ElektronikaDonBosco/Mesa-de-mezclas/README.md

# MESA DE MEZCLAS

## GRUPO_MIXER_1500 (Irene, Aritz y Amaia)

### Este proyecto consiste en una mesa de mezclas. La mesa de mezcla de audio o mezcladora de sonidos es un dispositivo electrónico al cual se conectan diversos elementos emisores de audio, tales como micrófonos etc. 

### Antes de profundizar en nuestro proyecto aquí tenéis la introducción de lo que vamos a ver:
Mesa

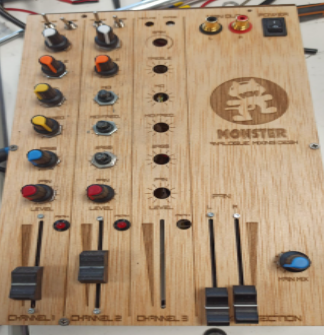
[picture p1: Imágenes/mesa_chasis.PNG]


# Introdución

## 1.- Presentación General

## 2.- Cómo funciona una mesa de mezclas (con sus partes)

### a- Entrada de audio

### b- Preamplificación

### c- Control de tono

### d- Fader y módulo de panorama

### e- Indicador de sobrecarga overload indicator

### f-Master
### g-Salida circuito
## 3.-Fuente de alimentación 
## 4.-Prototipo y diseño del chasis

### a-Planos y medidas
### b-Materiales

## 5.- Componentes importantes/distintos
### a-Potenciómetros
### b-Conmutadores

## 6.- Programas que hemos utilizado

### a-Proteus
### b-Circuit Cam

## 7.- Como hicimos el proyecto

## 8.- Futuras mejoras

## 9- Conclusiones
### -

### -

### -

## 1.- Presentación General

### Este proyecto ha sido desarrollado por alumnos de Mantenimiento Electrónico de Don Bosco (Errenteria). El proyecto tuvo inicio a mediados de Diciembre del 2020 y finalizo a mediados de Febrero del 2021.

### Esta mesa está alimentada a +15V y -15V  y tendrá un overload por si hay alguna sobrecarga además de un master. La mesa se compone de 3 canales de audio con entradas Jac y XLR cada una y salidas RCA en el Master.

### En cuanto a su chasis se hizo de parte de madera y parte metacrilato.

## 2.- Cómo funciona una mesa de mezclas (con sus partes)

### a.- MICRÓFONO Y PREAMPLIFICACIÓN

### Conexionado entradas:
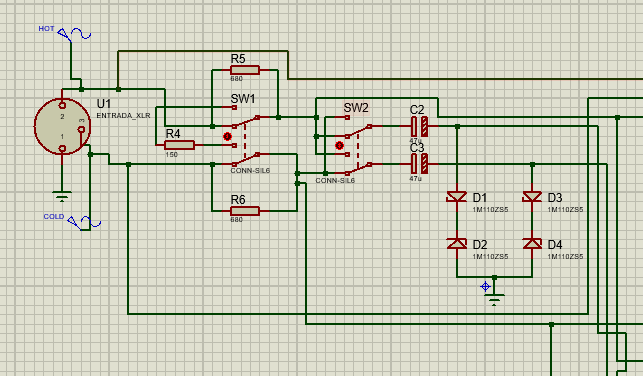
[picture p2: Imágenes/ENTRADA_AUDIO.PNG]
ENTRADA_AUDIO

### Para el micrófono se ha puesto un conector XLR o Jac ya que son para insertar cables con señal balanceada, es decir, el bus tiene tres conectores. 
#### En un conductor se manda la señal de audio (positivo o Hot) y en el otro se manda la misma señal, pero de forma invertida es decir, con un desfase de 180º (negativo o Cold), el tercer conductor sería la tierra de nuestra entrada de audio. 
#### Nuestro conector:



##### En está imagen podéis ver el conexionado de los extremos del cable XLR



###### 1-GROUND
###### 2-V+
###### 3-V-

##### En está imagen podéis ver el conexionado de los extremos del cable XLR

##### En está imagen podéis ver el conexionado del cable Jac comparado y con los XLR



#### Con este tipo de conexión logramos eliminar el ruido y obtener un audio de mayor volumen y amplitud, que se logra de la siguiente manera: al momento de conectar el cable a un preamplificador, el equipo invierte la señal que viene en el conductor &quot;Cold&quot; convirtiéndola en una señal igual a la señal &quot;Hot&quot;, con la característica de que el ruido que lleva se queda en la misma forma.

#### El equipo suma la señal del conductor &quot;Hot&quot; con la señal &quot;Cold&quot;, el resultado es una señal de audio del doble de amplitud y una cancelación de ruido, ya que están en sentido contrario. Con la siguiente imagen vemos de forma gráfica lo que sucede:
Hot y COLD



### En la preamplificación tenemos dos switches:

### Primer switch: 
#### Se encarga de conmutar la señal. Si se quiere conectar un instrumento de línea, se activa el switch para el otro lado, la señal hot pasa por R5 y la señal cold pasa por R6, y además, se quedan Cold y hot conectados entre ellos. En esa configuración se consigue un desgaste de 20dB. O dicho de otra forma, a la hora de conectar un instrumento con una tensión mayor se activa una resistencia adicional para que nuestro circuito pueda soportarla.
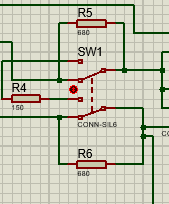
[picture p3: Imágenes/sw1.PNG]
sw1


### Segundo switch: 
#### Se encarga de hacer la suma de las señales la de entrada hot y la entrada cold (con un desfase de 180º). Si hay dos micrófonos si uno está muy cerca del otro, es posible que se solapen esto hace que las señales se anulen entre sí. Para que esto no pase la señal de un micrófono se desfasa 180º.

sw2


### b.-Preamplificación
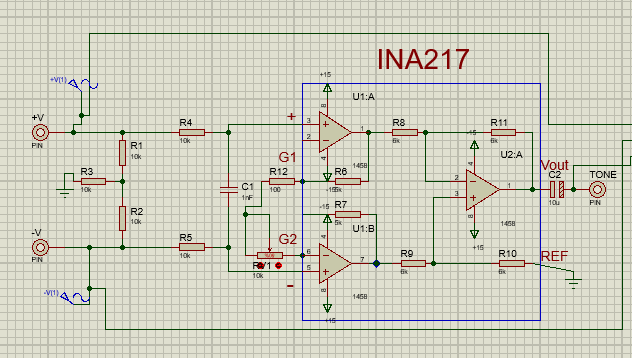
[picture p4: Imágenes/PREAMPLIFICACIÓN.PNG]
preamp
 

### En está etapa como podéis ver contaremos con el INA217 o tambien llamado amplificador instrumental, el cual, se compone interiormente por 3 amplificadores, su función principal es unir las dos señales La hot y cold para así solo optener una a la salida amplificada de está etapa.

#### El INA217 es ideal para señales de audio de bajo nivel, como baja impedancia balanceada micrófonos, muchos instrumentos industriales, médicos y de instrumentación. Las aplicaciones también se benefician de su bajo nivel de ruido y amplio ancho de banda. Los circuitos de cancelación de distorsión únicos reducen la distorsión a niveles extremadamente bajos, incluso en alta ganancia. 
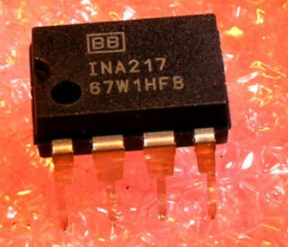
[picture p5: Imágenes/INA_FOTO.PNG]




### -Circuito de amplificación: Se basa en un amplificador no invertido.
#### La resistencia variable RV1 tiene una masa conectada. Cuando el cursor está en el medio de RV1, 50% de la trayectoria de RV1, las ondas de salida y entrada son las mismas, con ganancia = 1 o 0 dB.

#### Cuando el cursor se coloca en el 75% de la trayectoria RV1, la masa se acerca a la entrada positiva y la señal se cancela. Si los valores R1, RV1 y R2 tienen los valores correctos, como se muestra en la figura, colocando el cursor en esta posición, la señal de salida será la mitad de la entrada, la ganancia es = 0.5 o -6db.
#### Cuando coloca el cursor en el 25% de la trayectoria RV1, la masa se acerca a la entrada negativa. Cuando la señal se cancela en la entrada negativa, se amplificará en la salida. Ganancia = 2db-6db. 

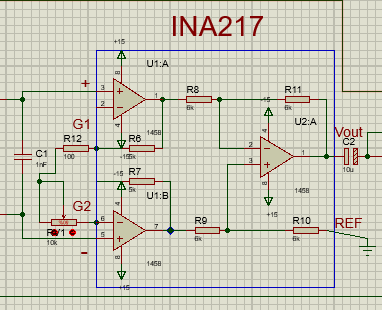
[picture p6: Imágenes/INA217.PNG]
ina


### En está etapa también es importante añadir que contamos con un potenciómetro. Pero no es un potenciómetro cualquiera sino uno logarítmico. Este tipo de potenciómetros los explicaremos con más detalle en componentes importes de nuestro circuito. Este potenciómetro tendrá que ser de 10 Ks.



### C-Módulo de tono
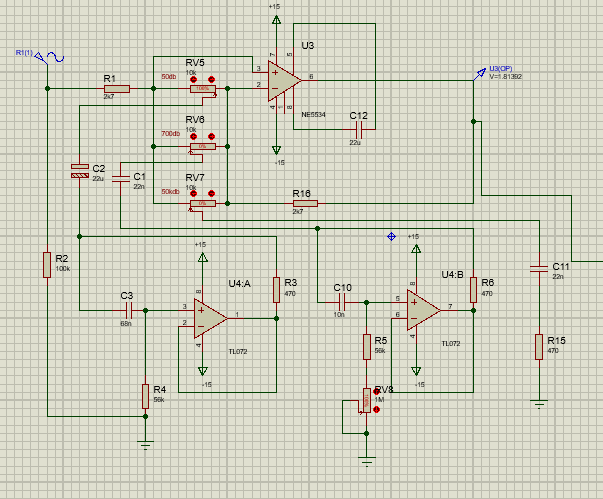
[picture p7: Imágenes/MÓDULO_TONO.PNG]
cc
 
### Para esté circuito necesitaremos 2 amplificadores operacionales un NE5534 y un TL072
#### NE5534:





#### TL072:





### En está etapa todos los potenciómetros serán lineales.
#### En esta etapa según la señal que recibamos bien sea de altos(Rv7), medios(Rv6) o bajos(Rv5)  podremos balancear la señal a la mejor calidad auditiva según a cuanta frecuencia esté llegando nuestra señal. Estos potenciómetros serán de 10Ks.



s

#### De la misma manera en este circuito contamos con un potenciómetro adicional de 1M:



#### Con este potenciómetro podremos balancear la señal en caso de que esté en el punto medio:
#### -bajo-medio
#### -medio-alto 

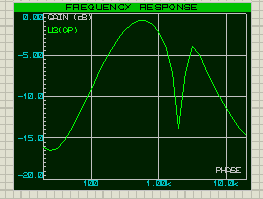
[picture p8: Imágenes/GRÁFICO_TONO.PNG]


#### En cuanto a las frecuencia que se adecua a cada etapa aquí tenéis un resumido esquema de estas frecuencias:
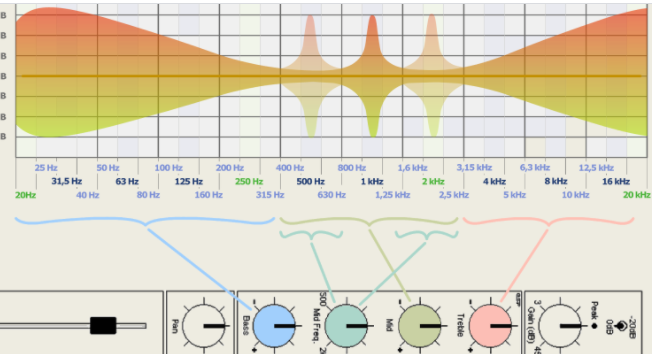
[picture p9: Imágenes/tono_hz.PNG]

#### -Azul: Bajos
#### -Verde musgo: Medios
#### -Rojo: Altos
#### -Verde pino: Potenciómetro balance (Bajo-Medio) y (Medio-Alto)

### d.-Fader y módulo de panorama

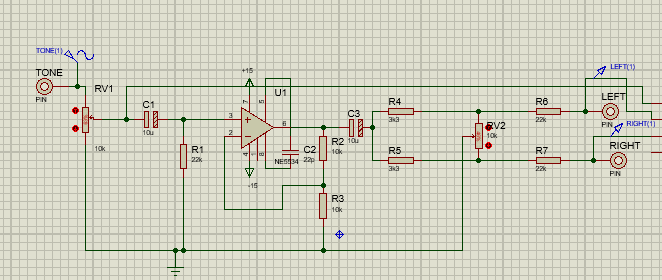
[picture p10: Imágenes/FADER.PNG]


### Para está etapa utilizaremos el amplificador NE5534 de nuevo y un fadder(logarítmico) y un potenciómetro lineal los dos de 10Ks.
### Fadder:



#### El volumen de la señal se controla con el fader VR1 el cual es un potenciómetro logarítmico . Su cursor está conectado a la entrada positiva del amplificador operacional. El potenciómetro debe ser logarítmico, y el lado con mayor resistencia en el potenciómetro debe estar en la parte superior para igualar las variaciones de resistencia con las mayores diferencias de presión en volúmenes altos. Su función principal es controlar el volumen del canal.
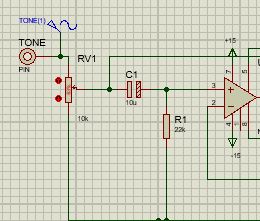
[picture p11: Imágenes/VOLUMEN.PNG]
 

#### Con el potenciómetro panorámico VR2 se puede enviar la señal a los canales izquierdo y derecho, en la proporcionalidad deseada. En resumen, Rv1 tiene la función de subir o bajar el volumen de nuestra señal y Rv2 tiene la función de dar prioridad al canal izquierdo o canal derecho de audio.
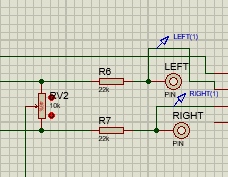
[picture p12: Imágenes/L_R.PNG]

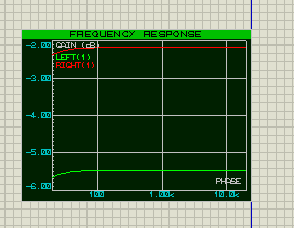
[picture p13: Imágenes/L_R_GRAFICO.PNG]


### e.-Indicador de sobrecargas "Overload Indicator")
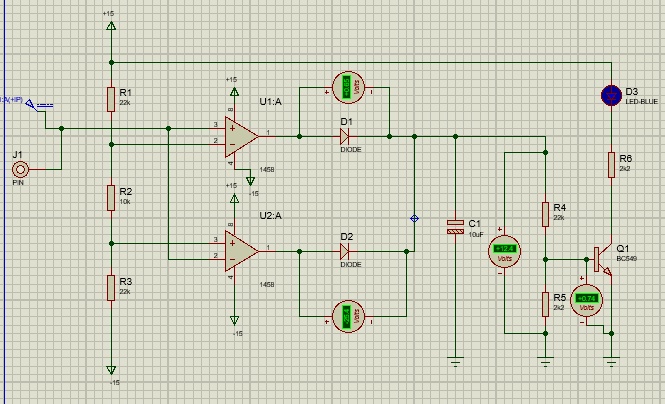
[picture p14: Imágenes/OVERLOAD.PNG]

#### Está etapa en la mesa de mezclas es opcional, su función principal es avisarnos cuando hay una sobrecarga en mi canal, este aviso no lo notificará a través de un led. Este led se encenderá cuando la tensión sea mayor a 3V o cuando esté por encima de los 6 Db. Esto sucederá cuando el transistor del esquema se excite. 
#### Esté circuito se compone principalmente de dos amplificadores LM1458 y del transistor BC549.
##### LM1458:



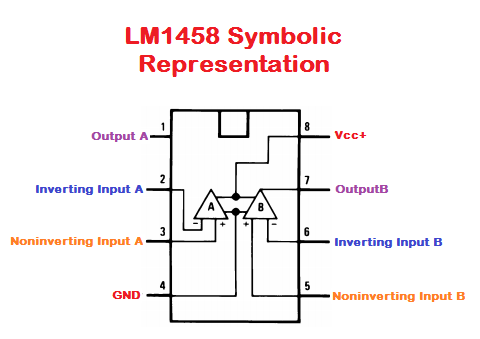
[picture p15: Imágenes/LM1458.PNG]


##### BC549: 
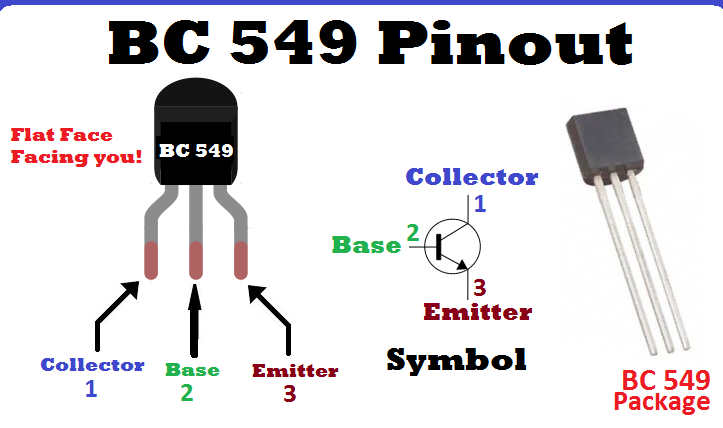
[picture p16: Imágenes/BC549.PNG]


### f.-Master:
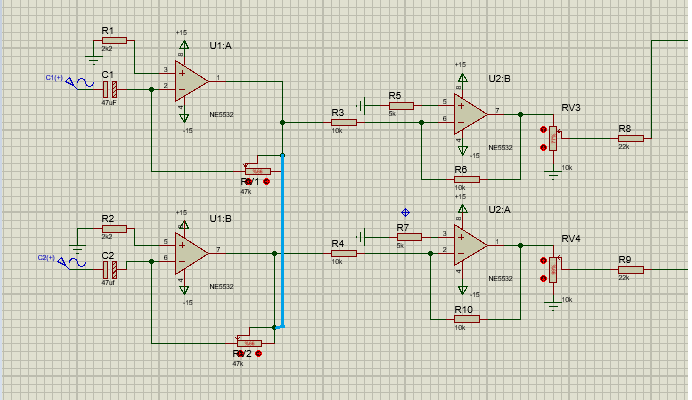
[picture p17: Imágenes/Master.PNG]

### Para está etapa necesitaremos 2 amplificadores NE5532, un potenciómetro tandem o doble(a poder ser logarítmico) de 47K y dos faders a su salida de 10ks.
##### NE5532:





##### Potenciómetro tandem: 



#### Este circuito es esencial para que esto lo podamos llamar mesa de mezclas, es la ultima etapa, al unir todas las salidas de los canales, por una parte el oído derecho Right(R) y por otra parte el oido izquierdo Left(L). 
#### Además de unir todos los canales manipula la ganancia de las entradas L y R en el circuito a través de un potenciómetro tándem.
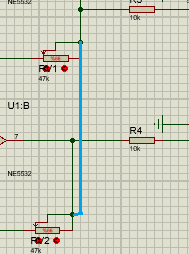
[picture p18: Imágenes/TAMDEM_ESQUEMA.PNG]

#### Al final de este circuito también disponemos con dos fadders los cuales, le van ha dar o quitar prioridad auditiva a cada entrada L o R independientemente.

### g.-Salida Circuito:
### La salida de nuestro circuito será mediante conectores RCA. El conexionado se haría de esta forma:
##### RCA:





#### -Rojo:Señal
#### -Negro:GND
## 3-Fuente de alimentación:
### Nosotros hemos calculado que nuestro circuito tiene un consumo de menos de 1A y que su alimentación es de +15v y -15V.
### Con estos datos hemos comprado una fuente de alimentación a su medida
### Fuente:
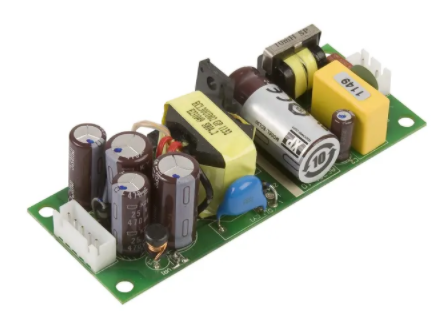
[picture p19: Imágenes/fuente.PNG]


### Link de compra:
[https://es.rs-online.com/web/p/fuentes-de-alimentacion-de-modo-conmutado-smps-integradas/1227791/](https://es.rs-online.com/web/p/fuentes-de-alimentacion-de-modo-conmutado-smps-integradas/1227791/)
## 4- Prototipo y diseño del chasis


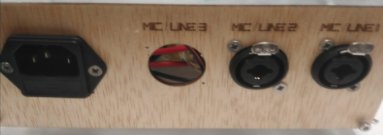
[picture p20: Imágenes/mesa_chasis2.PNG]

Esá es la página dónde nos han echo el diseño.
https://www.creartech.es/ 
### Nuestra caja está echa parte de madera y parte de metacrilato.

### La parte  trasera, los 3 laterales son de metraquilato

#### -La partes restantes es decir, el lateral superior y la parte delantera son de madera.
#### -El lateral superior tiene los conectores  de alimentación y el interruptor
#### En la parte superior tenemos: Switches, potenciómetros, Fadder , Entradas Jack/XLR y salidas RCA

#### Estás serían las medidas de nuestra caja:

## 5- Componentes importantes/distintos

### a.- Potenciómetros logarítmicos/lineales:

### -Lineales(B): En estos potenciómetros la resistencia es igual hacia ambas direcciones, hay que tomar en cuenta que el decremento de el valor de la resistencia se produzca de izquierda a derecha y no al revés.

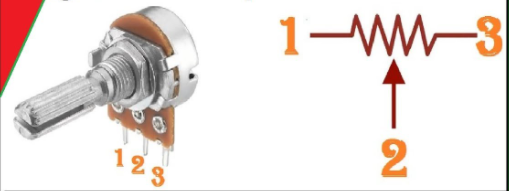
[picture p21: Imágenes/pot.PNG]


### -Logarítmicos(A):  Estos potenciómetros se caracterizan por ser exclusivos para el audio puesto que se comportan de la misma forma que un oído humano. En tensiones bajas la resistencia sería alta y en tensiones altas la resistencia sería baja. Puesto que el oído humano diferencia mejor el volumen alto al bajo. Por lo tanto la resistencia no es igual a ambos lados y esto es una cosa que hay que tener en cuenta a la hora de hacer el conexionado de los potenciómetros a la placa.



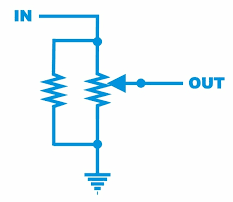
[picture p22: Imágenes/pot_log.PNG]


### b.- Fadder: Estos potenciómetros también son logarítmicos pero su patillaje es distinto. A la hora del conexionado es otro apartado a tomar en cuenta.

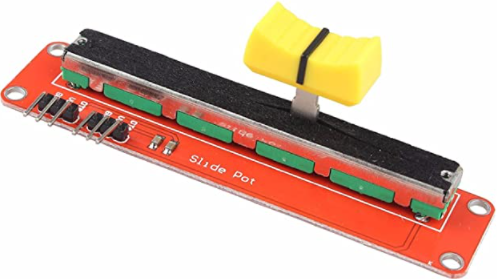
[picture p23: Imágenes/fadeee.PNG]




### c.- Switches: Los Switches del esquema y los físicos tienen un orden de patillaje lógico pero no es el mismo por lo tanto es otro apartado a tomar en cuenta. 
#### Su funcionamiento sería el siguiente, un Swich se compone de 6 pines. Cuando tu activas el interruptor los dos pines paralelos del lado opuesto se activan y salen cada uno
#### por el pin contiguo del medio. Al cambiar de dirección el interruptor pararían los pines paralelos del otro lado opuesto por los pin contiguo del medio.





##### COMPONENTES MÁS IMPORTANTES
COMPONENTES | Cantidad |
------------ | ------------ 
POTENCIMÉTROS LINEALES 10K | 12 unid
POTENCIMÉTROS LINEALES 1M| 3 unid
POTENCIMÉTROS LOG 10k | 3 unid
POTENCIMÉTRO Tamdem/lin 47K | 1 unid
FADERS    10k         | 5 unid
SWITCHES              | 6 unid
AMPLIFICADOR INA217  | 3 unid  
AMPLIFICADOR NE5534 | 6 unid
AMPLIFICADOR TL072 | 3 unid
AMPLIFICADOR LM1458 | 3 unid
AMPLIFICADOR NE5532 | 1 unid 
TRANSISTOR   BC549 |  3 unid
Entradas XLR/Jack            | 3unid
Salidas RCA     | 2 unid

## 6- Programas que hemos utilizado

### Proteus: con este programa podremos crear los diferentes circuitos que necesitamos y podremos simularlos en el. De esta forma podremos comprobar de antemano posibles fallos que pueden aparecer.

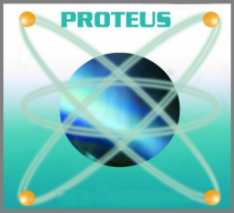
[picture p24: Imágenes/proteus.PNG]



####  Además, hay un apartado en el proteus donde podemos hacer una de una PCB y descargar todas las capas que compone el  archivo.



### CircuitCam: Cuando hallamos descargado estas capas anteriormente mencionadas podremos unificarlas en esté programa y hacer alguna pequeña modificación como un recorte al rededor de la placa o poner alguna nomenclatura en la propia placa. 
 
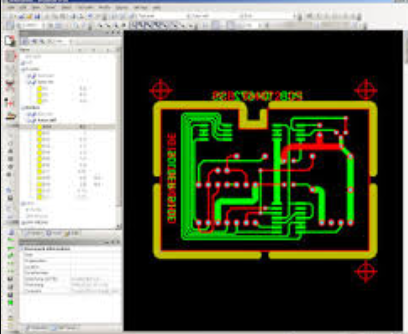
[picture p25: Imágenes/CIRCUIT.PNG]


### LPKF: Es la fresadora que hemos usado, una vez unificado el archivo en el CircuitCam nos lo pasará a formato .LMD y entoncen podremos fresarlo en está maquina.
 

#### Todos los Proteus que hemos utilizado están subidos también a esta plataforma, pero aun así explicaremos un poco como hemos hecho todo. También subiremos el instalador de Proteus.

#### Os dejamos un vídeo de como usar Proteus por si queréis hacer vuestro propio diseño de este proyecto:
(https://www.youtube.com/watch?v=zb5OJxtPjvw)
#### En caso de que queráis modificar la PCB o hacer una nueva, aquí tenéis un vídeo de está explicación
(https://www.youtube.com/watch?v=XJa_qg5qkqw&feature=emb_logo&ab_channel=KrissElectronics)

### Después si queremos hacer una PCB, para poder pasarla al Circuit Cam los pasos son los siguientes: 

#### 1-Le daremos al icono rojo que aparece debajo de design.

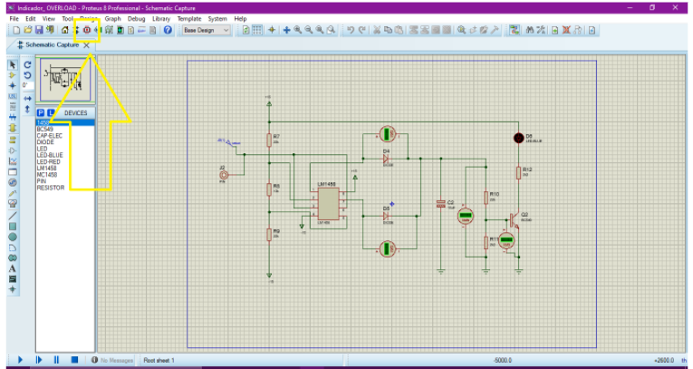
[picture p26: Imágenes/1.PNG]


#### 2-Aparecerá una nueva página en negro donde habrá que hacer la PCB. 

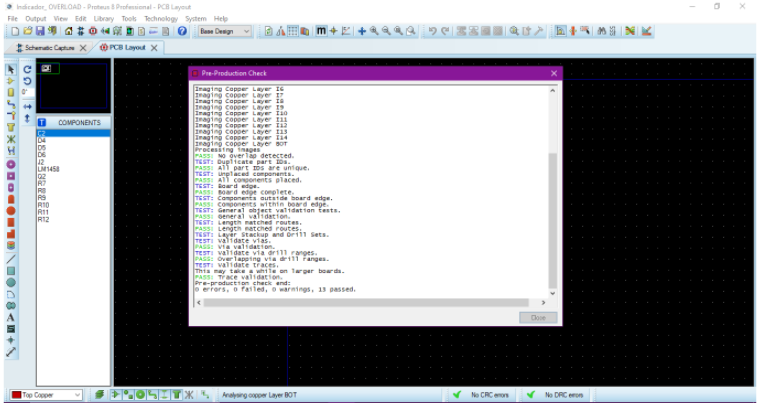
[picture p27: Imágenes/2.PNG]


#### 3-Una vez terminada la PCB, hay que sacar los ficheros para poder llevarlo al Circuit Cam. Para ello, hay que clicar `Output´ (que está arriba a la izquierda), darle a `Generate Gerber/Excellon file´, le damos a Yes, y aparecerá una pantalla como la de a continuación.

#### 4-A continuación nos saldrá la pantalla donde podemos escoger donde guardar nuestros archivos.

#### 5-Abrimos el Circuit Cam (pondremos link también para poder descargarlo)

#### 6-Una vez abierto, tenemos que clicar en el icono que aparece en la imagen siguiente, para ir poniendo las capas de nuestra placa.

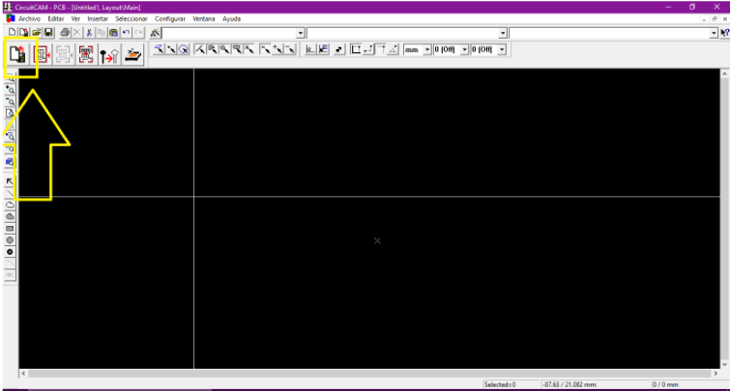
[picture p28: Imágenes/3.PNG]


#### 7-Cuando clicamos nos aparecerá esta pantalla:
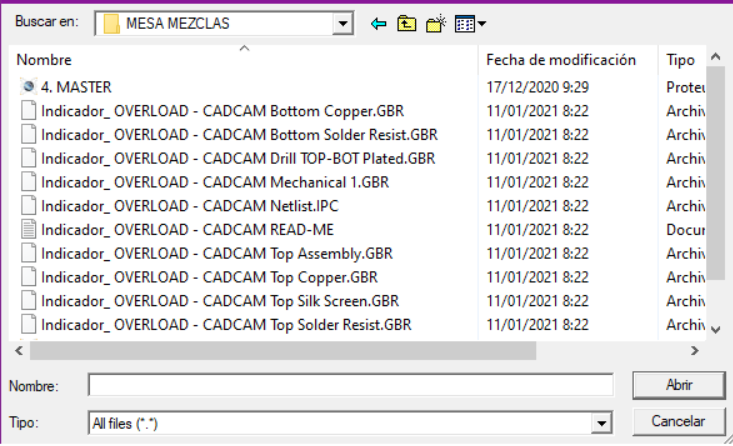
[picture p29: Imágenes/4.PNG]


#### 8-Clicamos en Bottom Copper.GBR y aparecerá esta pantalla:
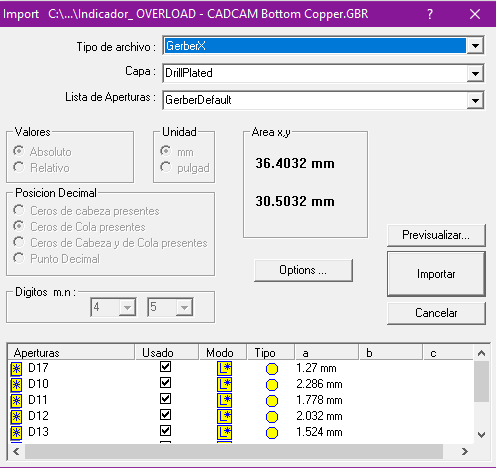
[picture p30: Imágenes/5.PNG]


#### 9-En el apartado de capas, tenemos que buscar la que ponga Bottom Layer, y le damos a Importar.

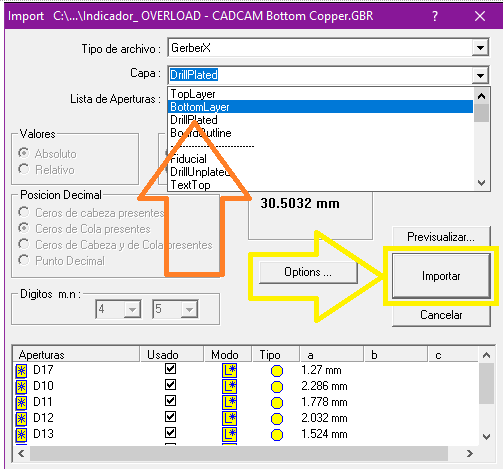
[picture p31: Imágenes/6.PNG]


#### 10-Si tenéis Circuit Cam pirata, os saltará un error, pero le dais a aceptar y la capa se habrá hecho igualmente.
#### Saldrá algo tal que así:

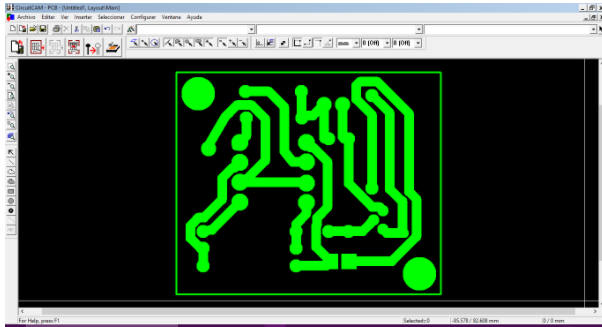
[picture p32: Imágenes/7.PNG]


#### 11- Se hace los mismo con el resto de capas en este orden:

##### 1.- Bottom Copper → Bottom Layer

##### 2.- Top Cooper → Top Layer

##### 3.- Drill Top-Bot → DrillPlated

#### 12-Una vez terminadas estas capas, se hace el contorno para el recorte. Para ello se la da al icono de al lado del que hemos clicado antes.
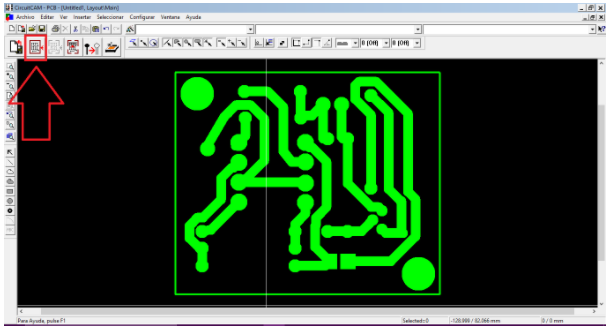
[picture p33: Imágenes/8.PNG]


#### 13-En la pantalla que aparece a continuación yo recomiendo poner las siguientes características y después hay que clicar en `Ejecutar´.

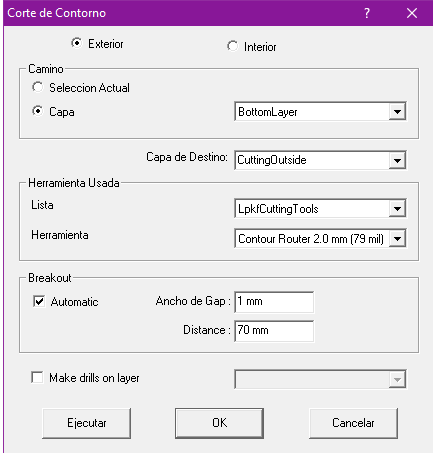
[picture p34: Imágenes/9.PNG]


#### 14-Por último aislamos todas las capas dándole al botón indicado en azul, y guardamos nuestro proyecto dándole al botón indicado en morado. Se nos formarán dos archivos, pero el que se usa para la LPKF es el archivo .LMD

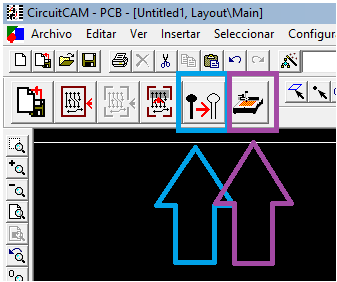
[picture p35: Imágenes/10.PNG]

## 7- Como hicimos el proyecto
### 1-Inicialmente nos hicimos una planificación del proyecto
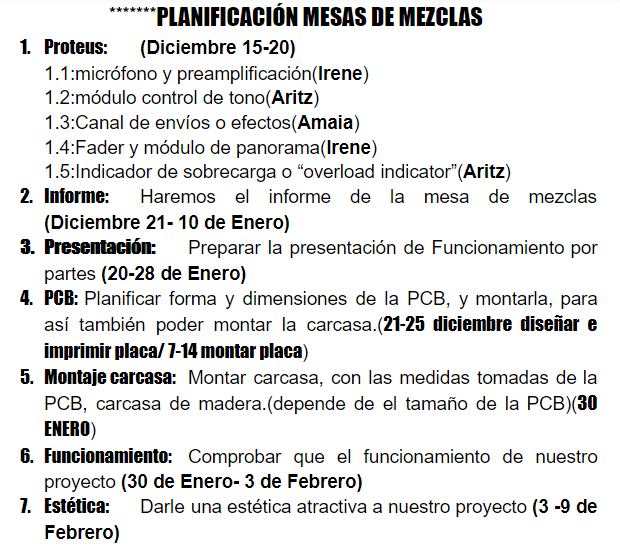
[picture p36: Imágenes/PLANING.PNG]

### 2-El siguiente paso fue hacer las simulaciones en proteus de la estapas y partes individuales del canal y demás circuitos cómo, el máster y el overload.
#### Canal:
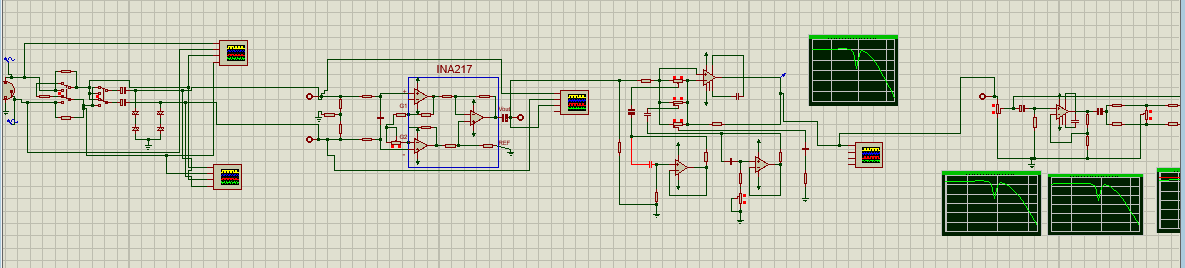
[picture p37: Imágenes/CANAL_GENERAL.PNG]

#### Master:
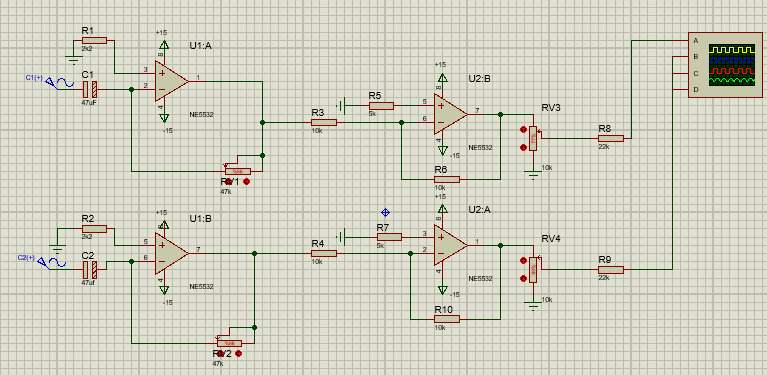
[picture p38: Imágenes/MASTER GENERAL.PNG]

#### Overload:
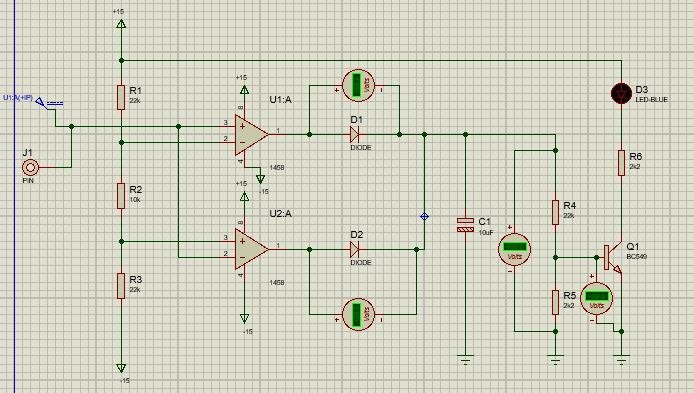
[picture p39: Imágenes/OVELOAD GENERAL.PNG]

### 3-Cuando todas las simulaciones funcionen se realizarán las PCBs de cada circuito, tomando en cuenta que queríamos que los potenciómetros y Swiches no estuvieran en la propia placa y así que ocupara menos espacio la placa.
#### Canal:


#### Master:
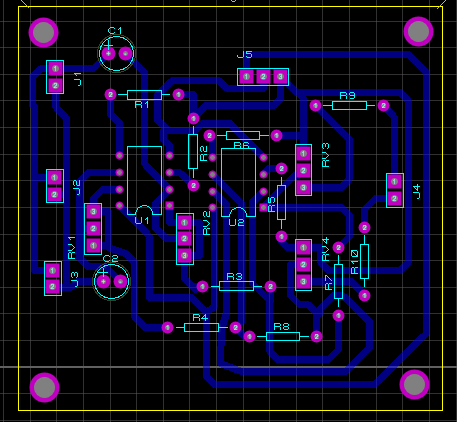
[picture p40: Imágenes/PCB MASTER.PNG]

#### Overload:
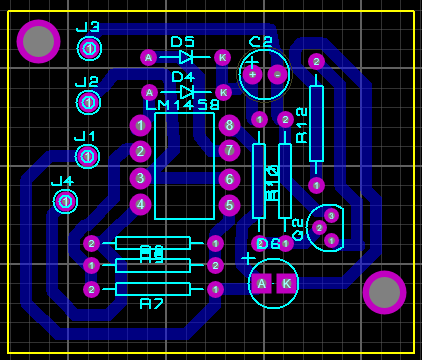
[picture p41: Imágenes/PCB OVERLOAD.PNG]

### 4-Habiendo echo todos los diseños, importaremos las distintas capas de cada placa al Circuit Cam.
#### Canal:
 

#### Master:
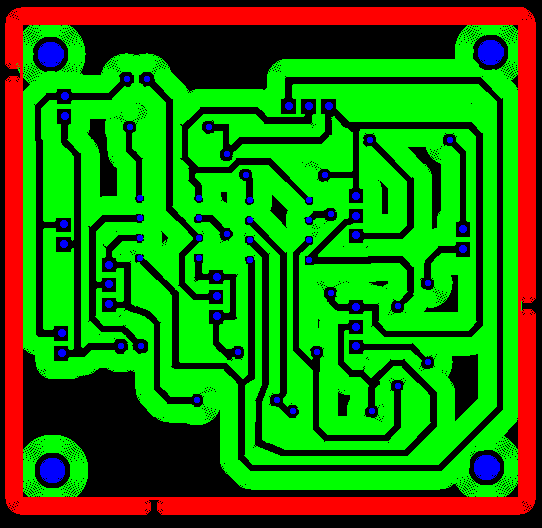
[picture p42: Imágenes/CIRCUIT_MASTER.PNG]


#### Overload:

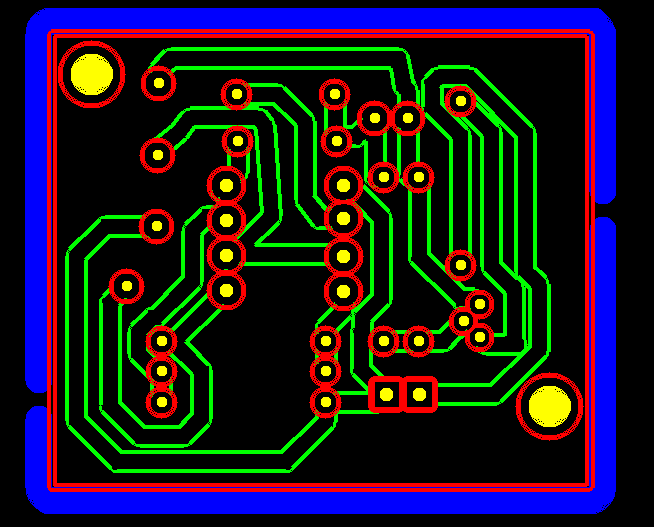
[picture p43: Imágenes/CIRCUIT_OVERLOAD.PNG]


### 5-Una vez obtenido el LMD del Circuit Cam fresaríamos la placa en el LPKF.

#### Canal:



#### Master:

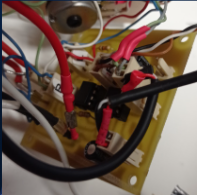
[picture p44: Imágenes/master_placa.PNG]


#### Overload:

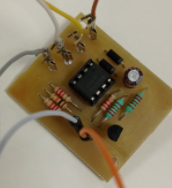
[picture p45: Imágenes/overload_placa.PNG]


### 6- Después de haberse fresado faltaría soldar correctamente cada componente a la placa, evitando lo mínimos cortos y puentes posibles.

##### Para ello seguimos estos pasos:

###### 1- MIentras se está fresando la placa etiquetar y coger correctemente cada componente que necesitamos para la placa que ballamos ha hacer. (recomendamos un canal puesto que es de los más costoso de hacer).

###### Comprobaciones Canal:

###### 1-Una vez fresado, nos aseguraríamos que los agujeros coinciden con todos los componentes correctamente, de no ser así con la brocadora manual agrandaríamos estos orificios.

###### 2-Soldariamos los componentes con mucho cuidado, recomendamos soldar los zócalos de los chips de los amplificadores y no el chip directamente.

###### 3- Después de hacer la primera etapa, con ayuda de un generador de señales introducimos la señal y nos aseguramos que SW1 atenua la señal Y que Sw2 genera un desfase.
Esto lo visualizaríamos en el ociloscopio.

###### 4-Posteriormente pasariamos a la segunda etapa, asegurandonos que el INA y el primer potencimétro que hace referencia a la ganancia funciona correctamente y no al revés. Para esto conectaremos dos fuentes de alimentzción en serie a +15V, la union GND y la salida de la fuente -15V.

###### 5-Una vez está etapa funcione pasaremos a la etapa de tono el la cual será necesarío hacer unos puentes  en el +15v y -15V de los amplificadores Tl072 y NE5534. Además habra que comprobar que los potencimetros de tono y el filtrador funciona adecuadamente en la frecuencia apropiada.

###### 6- Por último en el canal construiríamos la etapa de salida la cual hbria que comprobar el NE554 y el fadder del volumen junto con el potencimétro lineal. Y ver como le damos o le quitamos prioridad el canal derecho o al izquierdo.

###### 7- Después de soldarlo todo correctamente lo conectaríamos a la fuente correctamente y miraríamos los posibles errores que puedan suceder corrigiendo con paciencia uno por uno.
##### Comprovaciones master:

###### 1- Nos aseguramos que metiendo una señal de 0,5mV el tamdem amplifica su ganancia y los fadders la prioridad de cada canal.

###### 2- Una vez echo eso nos aseguramos que un canal funciona y lo unimos al master. Comprobamos que su salida funciona

###### 3- Conectamos la entrada a un dispositivo o entrada de audio externa y la salida a un amplificador. Y nos aseguramos que funcione.

###### 4- Conectamos los canales al master y nos aseguramos que funcionen.

##### Comprobaciones Overload:

###### 1- Introducimos una señal de entrada que en el osciloscopio podamos ver una caida  de 6db o que es lo mismo 3V. Si se enciende funciona correctamente y cuando introducimos una tensión menor se tendrá que apagar.

## 8- Fotos de nuestro prototipo final
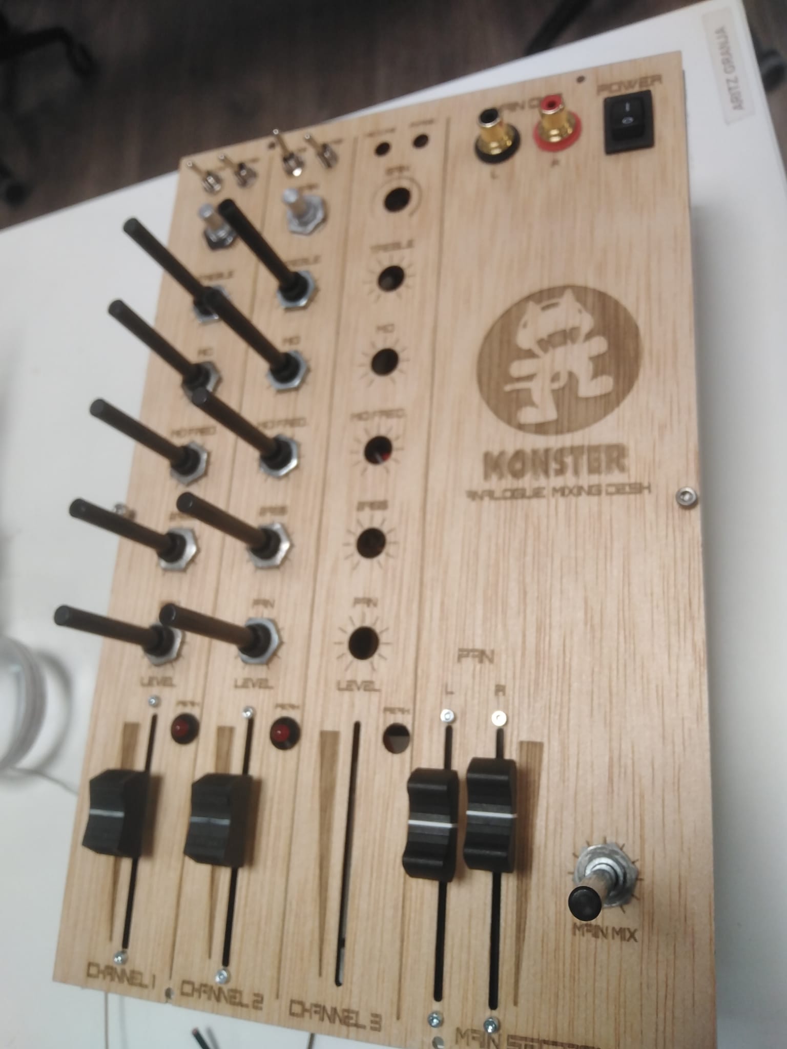
[picture p46: Imágenes/Chasis.jpeg]


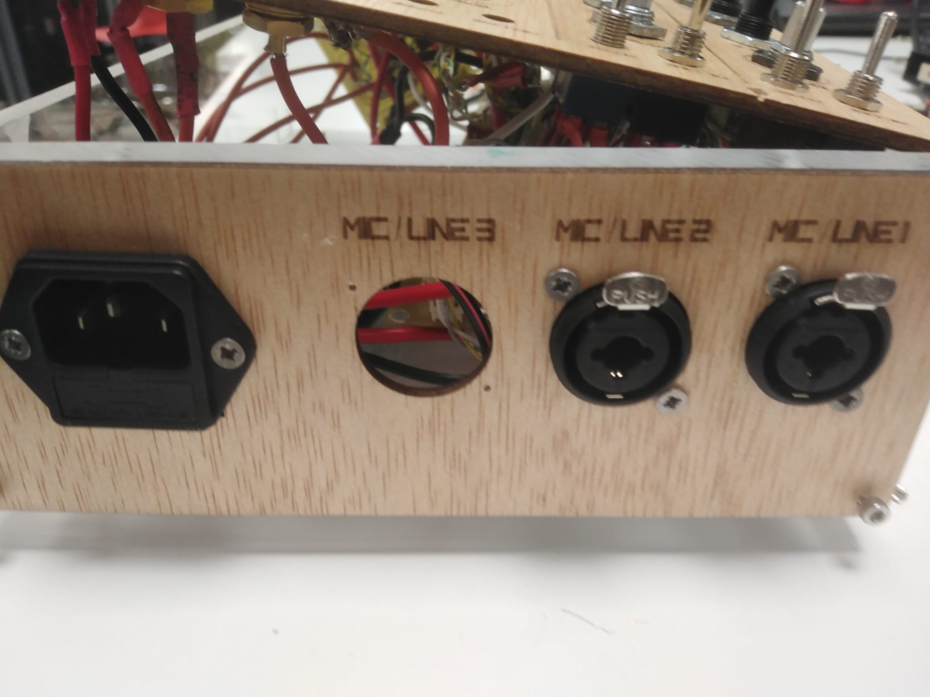
[picture p47: Imágenes/Chasis entradas.jpeg]


## 9- Futuras mejoras

### Mediante este apartado explicaremos los cambios que se podrían hacer para tener una mejor funcionalidad del proyecto.
### a.-Una PCB diseñada sin puentes con cables: al tener que hacer que hacer puentes con cablecitos, nos costó más encontrar algún que otro corto. Para la próxima, haríamos esos mismos puentes como pistas en la PCB.
### b.-Reajuste de elementos para una optimización de tamaño: nos hubiese gustado que la mesa fuese más pequeña.
### c.-Poner canales extras: en vez de 3 canales, hacer 4.
### d.-Una alimentación Phantom: para micrófonos que requieran de ella.
### e.-Tira de LEDs: para visualizar el volumen de la señal, así se mantiene en niveles óptimos para no distorsionar.
### a.-WIFI/Bluetooth: Pensamos que la mesa podría tener incorporada un chip de Wifi o Bluetooth para así conectar el móvil a la mesa y poner la música que uno quiera.



### b.- Fuente de alimentación Phantom: La mesa de mezclas tiene un preamplificador. Para alimentar este preamplificador se puede usar el phantom power que proviene de una unidad externa. La idea detrás de esto es que la mesa no necesite una fuente de alimentación propia, haciendo además que disminuya el tamaño, el peso y la practicidad general de la mesa. La denominación proviene del hecho de que la alimentación es «invisible» es decir que se encuentra dentro del dispositivo al que vamos a conectar la mesa y no por fuera o como parte de la mesa.



### c.-Poner un conector USB: Se podría añadir a la mesa un conector USB.

### d.- Carcasa de fuera de madera: La carcasa para la mesa de mezclas, en nuestro proyecto se hizo de aluminio, aunque en un principio nuestra idea fue hacerla de madera, ya que no es conductora, y además la mesa quedaría con un estilo más clásico. También tuvimos la idea de imprimir la carcasa en una impresora 3D, pero no tuvimos tiempo suficiente para aprender a diseñar la caja en el programa 3D y para imprimirla. Todas las mesas que veíamos en internet eran de plástico o de algún metal, con un estilo moderno, así que al final decidimos hacerla de aluminio, y lo más parecido al resto de mesas que se venden.

## 8.- Conclusiones
## En nuestra opinión, este reto nos ha parecido muy completo, y hemos aprendido mucho de él. Lo que más claro nos ha quedado, es que una PCB más limpia y sin puentes, los potenciómetros bien apuntados sus pines, y todos los conectores que van a las PCB iguales, nos hubiesen solucionado muchos problemas que hemos tenido y sobre todo nos hubiese ahorrado tiempo.
### Espero que este proyecto y su planteamiento os haya gustado. Os animamos a meteros en este mundo de jugar con el audio y las señales, puesto que es muy divertido y apasionante.
