ElektronikaDonBosco/Mesa-de-mezclas/Imágenes/Canal.jpeg

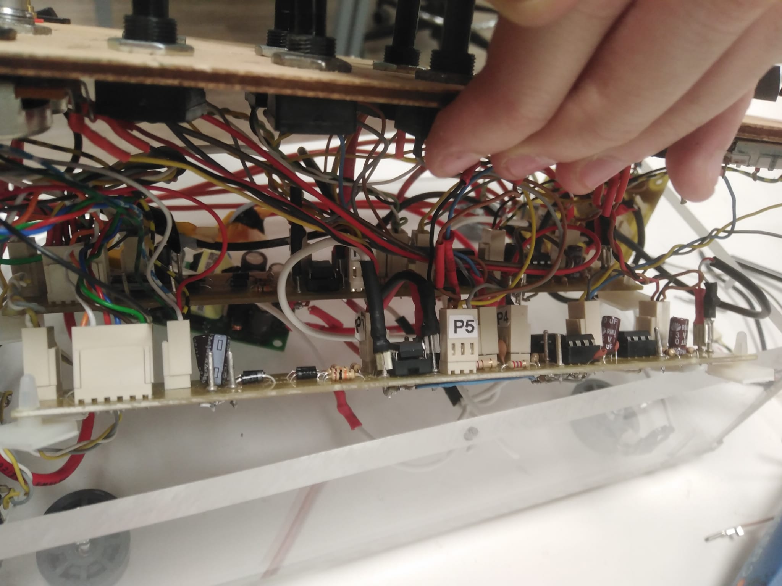
Imágenes/Canal.jpeg
