ElektronikaDonBosco/Mesa-de-mezclas/Imágenes/Fuente.jpeg

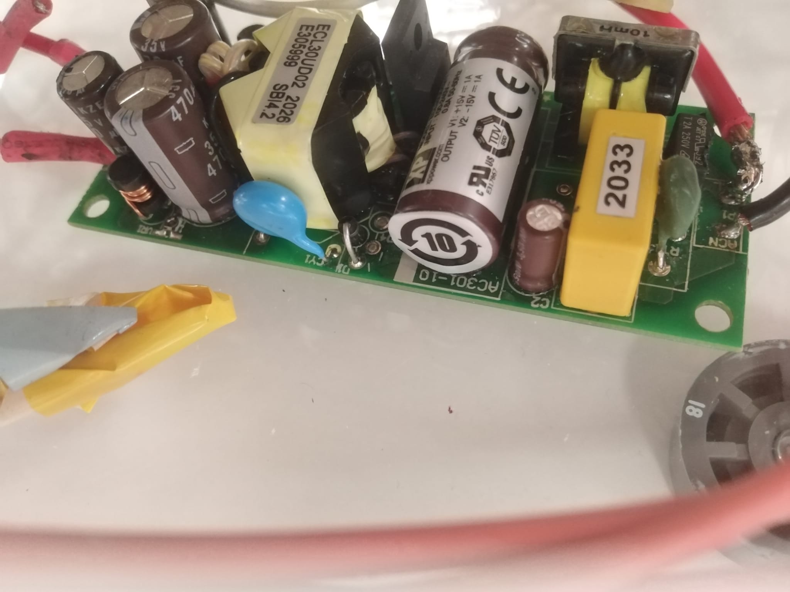
Imágenes/Fuente.jpeg
