ElektronikaDonBosco/Mesa-de-mezclas/Imágenes/L_R(ETAPA).PNG

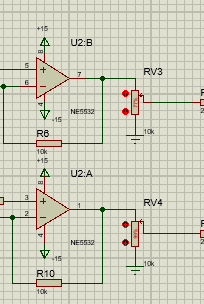
Imágenes/L_R(ETAPA).PNG
