ElektronikaDonBosco/Mesa-de-mezclas/Imágenes/Master.jpeg

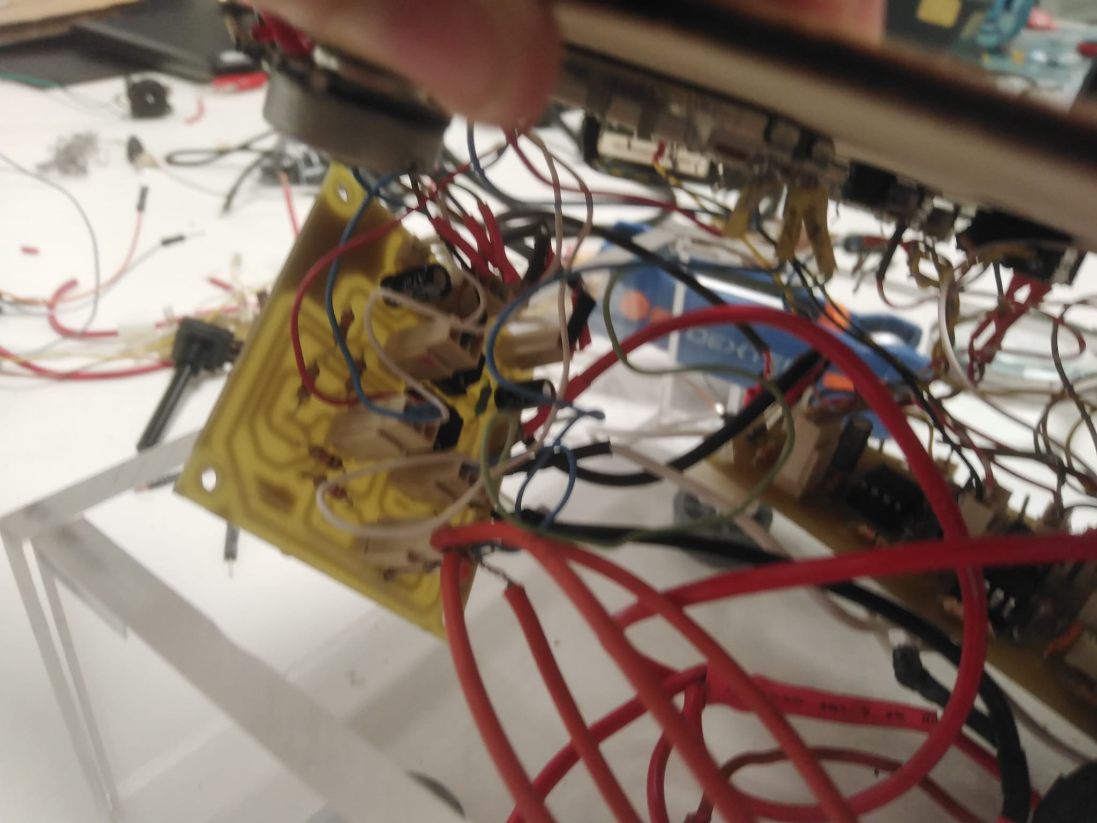
Imágenes/Master.jpeg
