ElektronikaDonBosco/Mesa-de-mezclas/Imágenes/RCA.PNG

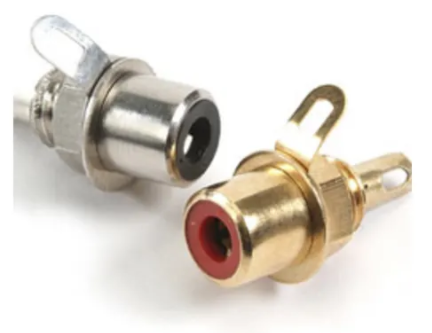
Imágenes/RCA.PNG
