ElektronikaDonBosco/Mesa-de-mezclas/(list of files, drawings)

Other design files:
PCB/CANAL (PUENTES ARRIBA).pdsprj
PCB/MASTER _PCB_NUEVO.pdsprj
PCB/PCB CANAL.pdsprj
PCB/PCB overload .pdsprj
Proteus/1-entrada audio.pdsprj
Proteus/2-preamplificación.pdsprj
Proteus/3-MODULO DE CONTROL DE TONO.pdsprj
Proteus/4-Fader y módulo de panorama.pdsprj
Proteus/5-Indicador_ OVERLOAD.pdsprj
Proteus/6-Master.pdsprj
Proteus/7- Canal.pdsprj
Proteus/8-Canal+master.pdsprj
Proteus/9-Canal+master+Overload.pdsprj
Proteus/10-Master+canales+Overload.pdsprj
