ElektronikaDonBosco/Mesa-de-mezclas/(commit log)

2021-02-05 Create Circuit cam
2021-02-06 Program file
    [1-entrada audio.pdsprj, 10-Master+canales+Overload.pdsprj, 2-preamplificación.pdsprj, 3-MODULO DE CONTROL DE TONO.pdsprj, 4-Fader y módulo de panorama.pdsprj, 5-Indicador_ OVERLOAD.pdsprj, 6-Master.pdsprj, 7- Canal.pdsprj]
2021-02-06 Create PCB
2021-02-06 Update and rename PCB/hola to PCB_Descripción
2021-02-06 Create CIRCUIT_CAM
